robinharris/ttn_node_c4di/README.md

# ttn_node_c4di

This repository supports the C4DI LoRa Build A Node workshop.

The node consists of:

	- RFM95 LoRa modem
	- Arduino Pro-Mini 3.3V 8MHz
	- Bosch BME280 temperature, humidity and pressure sensor

The Arduino sketch uses the Adafruit_BME280 Library, the Arduino-LMIC library and, for low power support the RocketScream Low_Power library.
