robinharris/ttn_node_c4di/(commit log)

2018-07-04 Release with otaa and abp samples
2018-07-04 Baud rate update
    Updated versions with 115200 baud rate set and correct device names
    [ttn_bme280_abp.ino]
